duongndrb/2021_micro_fluid/TONGHOP_BAOCAO/nckh_CONGTHUC.docx

1:1_1000

- V = π.r.r.L => L= V/(S*(Area))

V: volume (mm³)

r: radius of syringe (mm)

L: length of Run (mm)

S: the bottom Area of Syringe(mm²)

- Steps for L = L/(Pitch)*Step

Pitch: lead screw pitch distance (mm)

Step: number of steps for 1 resolution

- Flowrate = (Vout)/(Time)=Pitch.Speed.Area

Speed of motor (rpm)

Flowrate: the rate of flow ( μl/min)

Vout: the target output of volume (mm³)

Time: the time Run (ms)

- MicroStep = 16

- Giảm tốc (decelerate) = 49

-Speed = (Flowrate)/(Pitch*Area) = rpm; rpm: revolution per minutes

rpm= 60.000.000/(N*microstep*rpm)

N: pulse of revolution

=> delay = 60.000.000/(N*microstep*rpm)

delay(ms) : the time for stepper motor run

speed : max ( 2000 μl/min) and min ( 10
