duongndrb/2021_micro_fluid/DIEUKHIEN_1PUMp/90b0d93af070012e5861.jpg

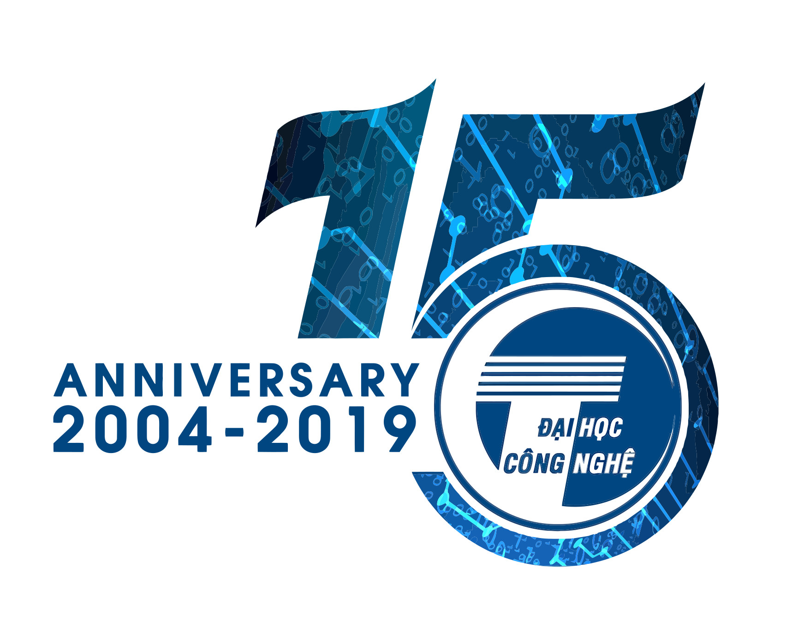
DIEUKHIEN_1PUMp/90b0d93af070012e5861.jpg
