duongndrb/2021_micro_fluid/DIEUKHIEN_1PUMp/8916abae7ffe8ea0d7ef.jpg

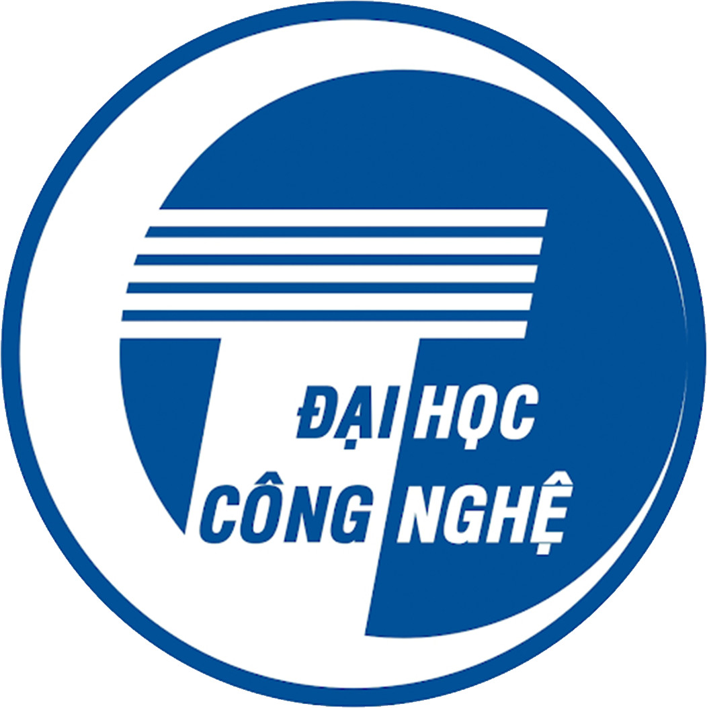
DIEUKHIEN_1PUMp/8916abae7ffe8ea0d7ef.jpg
