duongndrb/2021_micro_fluid/screenImage.png

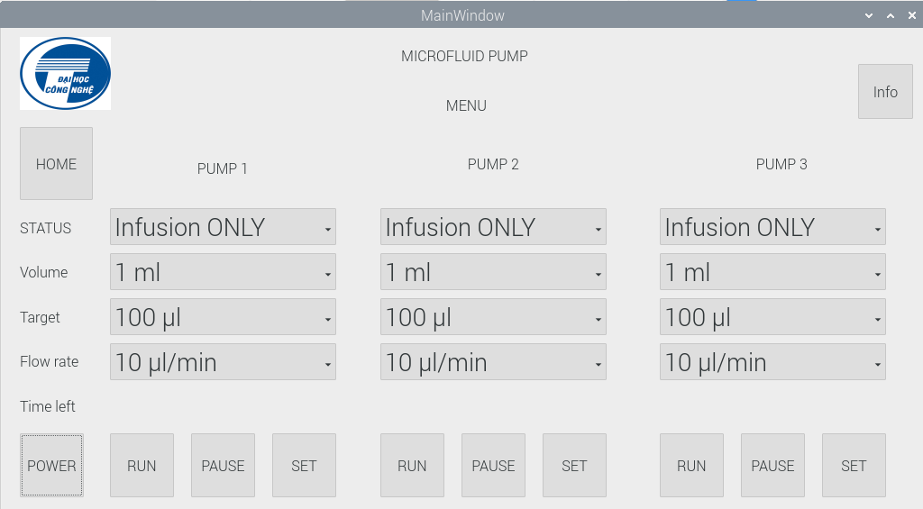
screenImage.png
