duongndrb/2021_micro_fluid/DIEUKHIEN_1PUMp/do_thong_so_do_thi_1.ino

#include <string.h>
//#include <String>

//SETTING MOTOR AND DRIVER
const int stepPin1 = 8;
const int dirPin1 = 24;

// khai báo chân ngắt động cơ
const byte interruptPin1 = 2;

/// chiều quay động cơ
bool dir1 = 1;

// định nghĩa các hằng số
#define Pi 3.14
#define pitch 2
#define fullStep 156800
#define microStep 16
#define deceleration 49

//khai báo chuỗi
String pi_cmd;
// khai báo các thông số của 3 máy bơm
// pump: tên các máy bơm
// status: trạng thái máy bơm sẽ chạy. Hút hay là đẩy
// volume: loại xi lanh vào máy bơm
// target: thể tích mong muốn thực hiện bơm
int Pump1 = 0;
int statusP1 = 0;
int volumeP1 = 0;
int targetP1 = 0;
int flowRateP1 = 0;
// khai bao thêm các thông số
int P = 0;
String pump;
String volume, comboString, target, flowRate;
byte phantach;
byte tach;

/// thời gian chạy của bơm
long int time1 = 0;

// counter
long int counter1 = 0;

long int currentCounter1 = 0;


// khai báo Speed
double speed1 = 0;

// thời gian delay
long int delay1 = 200;


// khai báo bán kính của xi lanh
double radius;
// khai báo thể tích xi lanh
double V;
// khai báo diện tích đáy của các xi lanh
double S1;

int steps = 200;

// số bước động cơ cần chạy
long int stepRun1 ;


String informationPump;

void setup()
{
  // put your setup code here, to run once:
  Serial.begin(9600);
  pinMode(stepPin1, OUTPUT);
  pinMode(dirPin1, OUTPUT);
  pinMode(interruptPin1, INPUT_PULLUP);

}

void loop()
{
  // put your main code here, to run repeatedly:
  if (Serial.available() )
  {

    char nhan = Serial.read();
    if ( nhan == '/')
         {
         if(informationPump.length() >1)
         {

         Serial.println(informationPump);
         // chuoi nhan duoc co dang 1_2_10_1000
         // 1: ky hieu cua may bom vs dong co tuong ung
         // 2: trang thai chay cua dong co(1: chi hut vao, 2: chi day ra, 3: hut vao roi day ra, 4: day ra roi hut vao )
         // 10: dung tich cua xi lanh lap vao (1,3,5,10,20,50)
         // 1000: the tich dung dich ra mong muon (100,200,...1000)
         pi_cmd = informationPump;
         //xu ly tach ky tu dau tien cua chuoi
         switch (pi_cmd.charAt(0))
         {
         case '1':
         Pump1 = 1;
         P = 1;
         Serial.println("Pump1");
         break;
         //      case '2':
         //        Pump2 = 2;
         //        P = 2;
         //        Serial.println("Pump2");
         //        break;
         //      case '3':
         //        Pump3 = 3;
         //        P = 3;
         //        Serial.println("Pump3");
         //        break;
         default:
         //pump = '0';
         P = 0;
       }
         Serial.print("P:");
         Serial.println(P);
         // xoa bo 2 ky tu
         pi_cmd.remove(0, 2);
         pi_cmd = pi_cmd;
         // xu ly trang thai may bom tu chuoi
         if (P == 1)
         {
         switch (pi_cmd.charAt(0))
         {
         case '1':
         statusP1 = 1;
         Serial.println("Infusion ONLY");
         break;
         case '2':
         statusP1 = 2;
         Serial.println("Withdraw ONLY");
         break;
         case '3':
         statusP1 = 3;
         Serial.println("Infusion/Withdraw");
         break;
         case '4':
         statusP1 = 4;
         Serial.println("Withdraw/Infusion");
         break;
         default:
         statusP1 = 0;
       }
         Serial.println(statusP1);
         Serial.println(pi_cmd);
         // xoa di cac ky tu
         pi_cmd.remove(0, 2);
         pi_cmd = pi_cmd;
         for (int i = 0; i < pi_cmd.length(); i++)
         {
         if (pi_cmd.charAt(i) == ':')
         {
         phantach = i; //tim vi tri cua dau "_"
       }
       }
         // phan tach the tich vao va ra mong muon
         volume = pi_cmd;
         comboString = pi_cmd;
         volume.remove(phantach);
         comboString.remove(0, phantach + 1);
         pi_cmd = comboString;
         for (int i = 0; i < pi_cmd.length(); i++)
         {

         if (pi_cmd.charAt(i) == '_')
         {
         tach = i; //tim vi tri cua dau "_"
       }
       }
         target = pi_cmd;
         flowRate = pi_cmd;
         target.remove(tach);
         //Serial.println(pi_cmd);
         //phantach[0] = 0;
         flowRate.remove(0, tach + 1);
         volumeP1 = volume.toInt();
         targetP1 = target.toInt();
         flowRateP1 = flowRate.toInt();
         Serial.print("volume and target:");
         Serial.println(volumeP1);
         Serial.println(targetP1);
         Serial.print("flowRate:");
         Serial.println(flowRateP1);
       }
         else
         {
         Serial.println("Not pump choose");
       }
       }
       }
         // khi nhan nut RUN o man hinh cam ung, thong tin truyen vao va chay dong cow
         if (informationPump == "r1")
         {

         // tinh ban kinh cua bom xi lanh

         switch (volumeP1)
         {
         case 1:
         radius = 2.45;
         break;
         case 3:
         //radius = ;
         break;
         case 5:
         //radius = ;
         break;
         case 10:
         //radius = ;
         break;
         case 20:
         //radius = ;
         break;
         case 50:
         //radius =;
         break;
         default:
         radius = 0;
       }
         Serial.print("radius:");
         Serial.println(radius);
         // tinh dien tich day
         S1 = Pi * radius * radius;
         Serial.print("Area:");
         Serial.println(S1);
         // tinh so step can chay tuong ung vs the tich ra mong muon
         if (targetP1 <= (volumeP1 * 1000))
         {
         double lengthRun1 = targetP1 / S1;

         stepRun1 = (lengthRun1 / pitch) * fullStep;
         stepRun1 = stepRun1 / (double)deceleration;
         stepRun1 = stepRun1 / (double)microStep;
         stepRun1 = (long int)stepRun1;
       }
         Serial.print("so Step:");
         Serial.println(stepRun1);

         Serial.print("flow Rate");
         Serial.println(flowRateP1);
         flowRateP1 = (double)flowRateP1;
         speed1 = flowRateP1 / (pitch * S1);
         Serial.print("toc do:");
         Serial.println(speed1);
         delay1 = (double)delay1;
         delay1 = 60000000 / (speed1 * steps * microStep * 49);
         delay1 = (int)delay1;

         Serial.print("delay:");
         Serial.println(delay1);
         // setup chieu quay va quay so buoc tuong ung de chay dong co
         switch (statusP1)
         {
         // trang thai chi hut vao
         case 1:
         dir1 = 1;
         time1 = millis();
         digitalWrite(dirPin1, dir1);
         for (long int x = 0; x < stepRun1; x++)
         {
         for (long int i = 0; i < microStep * deceleration; i++)
         {
         digitalWrite(stepPin1, HIGH);
         delayMicroseconds(1);
         digitalWrite(stepPin1, LOW);
         delayMicroseconds(delay1);
       }
       }
         time1 = millis() - time1;
         Serial.println(time1);
         break;

         // trang thai chi day ra
         case 2:
         dir1 = 0;
         time1 = millis();
         digitalWrite(dirPin1, dir1);
         for (long int x = 0; x < stepRun1; x++)
         {
         for (long int i = 0; i < microStep * deceleration; i++)
         {
         digitalWrite(stepPin1, HIGH);
         delayMicroseconds(1);
         digitalWrite(stepPin1, LOW);
         delayMicroseconds(delay1);
       }
       }
         time1 = millis() - time1;
         Serial.println(time1);
         break;

         // trang thai hut vao va day ra
         case 3:
         dir1 = 1;
         time1 = millis();
         digitalWrite(dirPin1, dir1);
         for (long int x = 0; x < stepRun1; x++)
         {
         for (long int i = 0; i < microStep * deceleration; i++)
         {
         digitalWrite(stepPin1, HIGH);
         delayMicroseconds(1);
         digitalWrite(stepPin1, LOW);
         delayMicroseconds(delay1);
       }
       }
         dir1 != dir1;
         digitalWrite(dirPin1, dir1);
         for (long int x = 0; x < stepRun1; x++)
         {
         for (long int i = 0; i < microStep * deceleration; i++)
         {
         digitalWrite(stepPin1, HIGH);
         delayMicroseconds(1);
         digitalWrite(stepPin1, LOW);
         delayMicroseconds(delay1);
       }
       }
         time1 = millis() - time1;
         Serial.println(time1);
         break;

         // trang thai day ra va hut vao
         case 4:
         dir1 = 0;
         time1 = millis();
         digitalWrite(dirPin1, dir1);
         for (long int x = 0; x < stepRun1; x++)
         {
         for (long int i = 0; i < microStep * deceleration; i++)
         {
         digitalWrite(stepPin1, HIGH);
         delayMicroseconds(1);
         digitalWrite(stepPin1, LOW);
         delayMicroseconds(delay1);
       }
       }
         dir1 != dir1;
         digitalWrite(dirPin1, dir1);
         for (long int x = 0; x < stepRun1; x++)
         {
         for (long int i = 0; i < microStep * deceleration; i++)
         {
         digitalWrite(stepPin1, HIGH);
         delayMicroseconds(1);
         digitalWrite(stepPin1, LOW);
         delayMicroseconds(delay1);
       }
       }
         time1 = millis() - time1;
         Serial.println(time1);
         break;
         default:
         time1 = 0;
       }
       }

         //    if (informationPump == "q1")
         //    {
         //      digitalWrite(interruptPin1, HIGH);
         //      delayMicroseconds(1);
         //      attachInterrupt(digitalPinToInterrupt(interruptPin1), stopMotor1, LOW);
         //      //stopMotor1();
         //    }

       }
       }

         //void stopMotor1()
         //{
         //  digitalWrite(stepPin1, LOW);
         //}
